langhz666/stm32-sizhoufeixingqi/asset/remote.jpg

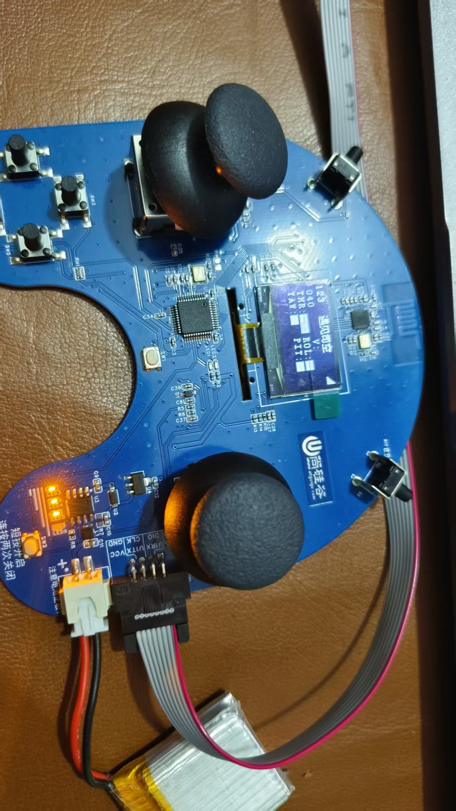
asset/remote.jpg
