langhz666/stm32-sizhoufeixingqi/Software/Flight_code/README.md

# STM32F103 四旋翼飞控系统

## 项目简介

基于STM32F103C8T6的四旋翼飞行器飞控系统，采用FreeRTOS实时操作系统，支持遥控飞行、定高悬停、自动降落等功能。

### 主要特性

- 串级PID控制 (角度环 + 角速度环)
- Mahony互补滤波姿态解算
- VL53L1X激光定高
- SI24R1 2.4G无线通信
- 自动解锁/锁定保护
- 遥控器断连自动降落
- LED状态指示
- 电池电压回传

---

## 硬件平台

### 核心器件

| 模块 | 型号 | 接口 | 引脚 | 说明 |
|---|---|---|---|---|
| 主控 | STM32F103C8T6 | - | - | ARM Cortex-M3, 72MHz, 64KB Flash, 20KB SRAM |
| IMU | MPU6050 | I2C1 | PB6(SCL), PB7(SDA) | 六轴姿态传感器, ±2000°/s, ±2g |
| 无线 | SI24R1 | SPI1 | PA5(CLK), PA6(MISO), PA7(MOSI), PA4(NSS) | 2.4G遥控通信, 1Mbps |
| 测距 | VL53L1X | I2C2 | PB10(SCL), PB11(SDA) | 激光测距, 40-4000mm |
| 电源 | IP5305T | GPIO | PB2(POWER_KEY) | 锂电池电源管理, 自动开关机 |
| 电池ADC | - | ADC1 | PB5(BAT_ADC) | 电池电压检测, 分压电阻1:2 |

### 电机配置

| 电机位置 | 定时器 | 通道 | 引脚 | 旋转方向 |
|---|---|---|---|---|
| 左上 | TIM3 | CH1 | PA6 | 顺时针 |
| 左下 | TIM4 | CH4 | PB9 | 逆时针 |
| 右上 | TIM2 | CH2 | PA1 | 顺时针 |
| 右下 | TIM1 | CH3 | PA10 | 逆时针 |

### LED配置

| LED | 引脚 | 功能 |
|-----|---|---|
| LED1 (左上) | PA12 | 遥控器连接状态 |
| LED2 (右上) | PA11 | 遥控器连接状态 |
| LED3 (右下) | PB15 | 飞行状态指示 |
| LED4 (左下) | PB14 | 飞行状态指示 |

### 电机布局 (俯视图)

```
        左上(顺时针)          右上(顺时针)
              \                /
               \              /
                \            /
                 ------------
                /            \
               /              \
              /                \
        左下(逆时针)          右下(逆时针)
```

---

## 软件架构

### 目录结构

```
├── Core/                        # STM32 HAL库生成代码
│   ├── Inc/                     # 头文件 (CubeMX生成)
│   │   ├── main.h              # 主头文件, GPIO引脚定义
│   │   ├── stm32f1xx_it.h      # 中断处理头文件
│   │   └── ...                 # 其他外设头文件
│   └── Src/                     # 源文件
│       ├── main.c              # 主程序入口
│       ├── stm32f1xx_it.c      # 中断处理 (含FreeRTOS SysTick)
│       └── ...                 # 其他外设初始化
│
├── Drivers/                     # STM32 HAL驱动库 (官方)
│   ├── CMSIS/                   # ARM CMSIS核心
│   └── STM32F1xx_HAL_Driver/   # STM32 HAL库
│
└── MDK-ARM/                     # 用户代码
    ├── Application/             # 应用层 (业务逻辑)
    │   ├── App_flight.c/h      # 飞行控制 (姿态解算+PID+混控)
    │   ├── App_freeRTOS_Task.c/h # FreeRTOS任务管理
    │   └── App_receive_data.c/h # 遥控数据接收与状态机
    │
    ├── common/                  # 公共模块 (算法)
    │   ├── Com_config.c/h      # 系统配置与数据结构
    │   ├── Com_debug.c/h       # 调试打印
    │   ├── Com_filter.c/h      # 滤波算法 (低通+卡尔曼)
    │   ├── Com_imu.c/h         # IMU姿态解算 (Mahony互补滤波)
    │   └── Com_pid.c/h         # PID控制算法
    │
    ├── interface/               # 硬件驱动层
    │   ├── Int_Mpu6050.c/h     # MPU6050驱动 (I2C)
    │   ├── Int_SI24R1.c/h      # SI24R1无线驱动 (SPI)
    │   ├── Int_motor.c/h       # 电机PWM驱动
    │   ├── Int_led.c/h         # LED驱动
    │   ├── Int_IP5305T.c/h     # 电源管理驱动
    │   ├── Int_bat_ADC.c/h     # 电池电压检测
    │   └── fix_height/         # 定高传感器
    │       ├── Int_VL53L1X.c/h # VL53L1X驱动
    │       ├── VL53L1X_api.c/h # ST官方API
    │       └── ...             # 平台适配层
    │
    └── freeRTOS/                # FreeRTOS内核 (官方)
        ├── tasks.c             # 任务管理
        ├── queue.c             # 队列
        ├── timers.c            # 软件定时器
        └── portable/           # 移植层
```

### 软件分层

```
┌─────────────────────────────────────────────────────────────┐
│                    应用层 (Application)                       │
│   App_flight.c        - 飞行控制业务逻辑                     │
│   App_receive_data.c  - 遥控数据解析与状态机                 │
│   App_freeRTOS_Task.c - 任务创建与调度                       │
├─────────────────────────────────────────────────────────────┤
│                    公共模块 (Common)                          │
│   Com_pid.c      - PID控制算法                              │
│   Com_imu.c      - 姿态解算算法                             │
│   Com_filter.c   - 滤波算法                                 │
│   Com_config.c   - 数据结构定义                             │
├─────────────────────────────────────────────────────────────┤
│                    硬件驱动层 (Interface)                     │
│   Int_Mpu6050.c  - MPU6050驱动                              │
│   Int_SI24R1.c   - SI24R1无线驱动                           │
│   Int_motor.c    - 电机驱动                                 │
│   Int_led.c      - LED驱动                                  │
│   Int_VL53L1X.c  - 激光测距驱动                             │
├─────────────────────────────────────────────────────────────┤
│                    HAL库层 (Drivers)                          │
│   STM32F1xx_HAL_Driver - STM32硬件抽象层                    │
│   CMSIS                 - ARM核心支持                       │
├─────────────────────────────────────────────────────────────┤
│                    硬件层 (Hardware)                          │
│   STM32F103C8T6 + MPU6050 + SI24R1 + VL53L1X + 电机        │
└─────────────────────────────────────────────────────────────┘
```

---

## 系统任务

### FreeRTOS任务配置

| 任务名 | 周期 | 优先级 | 栈大小 | 功能 |
|---|---|---|---|---|
| flight_task | 6ms (166Hz) | 3 | 512B | 姿态解算、PID控制、电机输出 |
| com_task | 10ms (100Hz) | 4 | 512B | 遥控数据接收、状态机处理 |
| power_task | 10s | 4 | 512B | 电源管理、自动开关机 |
| led_task | 100ms (10Hz) | 1 | 512B | 状态指示灯控制 |

### 任务优先级说明

- 优先级数值越小，优先级越低
- flight_task 优先级最高 (3)，确保姿态控制实时性
- com_task 和 power_task 优先级相同 (4)
- led_task 优先级最低 (1)，不影响飞行控制

### 任务间通信

```
com_task ──(TaskNotify)──> power_task    // 关机指令
flight_task ──(TaskNotify)──> com_task   // 故障处理完成
```

---

## 控制算法

### 1. 姿态解算 (Mahony互补滤波)

#### 算法原理

融合陀螺仪和加速度计数据，使用四元数表示姿态：

```
陀螺仪: 短期精度高，长期有漂移
加速度计: 长期稳定，短期有噪声

融合公式:
Gyro_corrected = Gyro_raw + Kp * error + Ki * ∫error dt

其中:
error = Acc_norm × Gravity_estimated (叉积表示姿态误差)
```

#### 参数配置

| 参数 | 值 | 说明 |
|---|-----|---|
| Kp | 0.8 | 加速度计修正权重 |
| Ki | 0.0003 | 陀螺仪零偏补偿 |
| 陀螺仪量程 | ±2000°/s | MPU6050配置 |
| 加速度计量程 | ±2g | MPU6050配置 |
| 积分时间 | 6ms | 任务周期 |

#### 输出

- 俯仰角 (Pitch): 绕Y轴旋转，抬头为正，范围 [-90°, +90°]
- 横滚角 (Roll): 绕X轴旋转，右倾为正，范围 [-180°, +180°]
- 偏航角 (Yaw): 绕Z轴旋转，顺时针为正，累积值

### 2. PID控制 (串级PID)

#### 控制结构

```
                    ┌─────────────┐
目标角度 ──────────>│   外环PID   │──────> 目标角速度
                    │  (角度环)   │
                    └─────────────┘
                           │
                           ▼
                    ┌─────────────┐
当前角速度 ────────>│   内环PID   │──────> 电机控制量
                    │ (角速度环)  │
                    └─────────────┘
```

#### 优势

- 内环响应快，能快速抑制角速度扰动
- 外环负责稳态精度
- 比单级PID具有更好的抗干扰性能

#### PID公式

```
output = Kp * err + Ki * ∫err*dt + Kd * derr/dt

其中:
err = measure - desire
```

#### 参数配置

**俯仰轴 (Pitch):**
| 环路 | Kp | Ki | Kd | 说明 |
|---|-----|-----|-----|---|
| 外环 (角度) | -3.50 | 0 | 0 | 纯比例控制 |
| 内环 (角速度) | 5.50 | 0 | 0.15 | 比例+微分 |

**横滚轴 (Roll):**
| 环路 | Kp | Ki | Kd | 说明 |
|---|-----|-----|-----|---|
| 外环 (角度) | -3.50 | 0 | 0 | 纯比例控制 |
| 内环 (角速度) | 5.50 | 0 | 0.15 | 比例+微分 |

**偏航轴 (Yaw):**
| 环路 | Kp | Ki | Kd | 说明 |
|---|-----|-----|-----|---|
| 外环 (角度) | -1.50 | 0 | 0 | 纯比例控制 |
| 内环 (角速度) | -2.50 | 0 | 0 | 纯比例控制 |

**高度环 (Height):**
| 环路 | Kp | Ki | Kd | 说明 |
|---|-----|-----|-----|---|
| 高度 | -1.3 | 0 | -0.05 | 比例+微分 |

#### 调参建议

1. **先调内环**: 确保角速度能快速跟踪指令
   - 从小Kp开始，逐渐增大
   - 加入适当的Kd抑制振荡

2. **再调外环**: 确保角度能快速稳定
   - 从小Kp开始，逐渐增大
   - 外环一般不需要Kd

3. **微调**: 根据飞行效果微调参数
   - 如果振荡: 减小Kp或增大Kd
   - 如果响应慢: 增大Kp
   - 如果有静态误差: 适当增加Ki

### 3. 滤波算法

#### 低通滤波 (陀螺仪)

```
output = alpha * newValue + (1-alpha) * preFilteredValue

参数: alpha = 0.15
作用: 滤除高频噪声
特点: 响应快，适合高频数据
```

#### 卡尔曼滤波 (加速度计)

```
预测:
P(k|k-1) = P(k-1|k-1) + Q

更新:
K = P(k|k-1) / (P(k|k-1) + R)
x(k|k) = x(k|k-1) + K * (z(k) - x(k|k-1))
P(k|k) = (1-K) * P(k|k-1)

参数: Q=0.001, R=0.543
作用: 平滑数据，滤除噪声
特点: 平滑性好，适合低频数据
```

### 4. 电机混控 (X型布局)

#### 混控公式

```
左上电机 = 油门 + 俯仰 - 横滚 + 偏航
左下电机 = 油门 - 俯仰 - 横滚 - 偏航
右上电机 = 油门 + 俯仰 + 横滚 - 偏航
右下电机 = 油门 - 俯仰 + 横滚 + 偏航
```

#### 符号说明

- 俯仰+: 抬头 (左上、右上电机加速)
- 横滚+: 右倾 (右上、右下电机加速)
- 偏航+: 顺时针旋转 (左上、左下电机加速)

#### 限幅

- 电机速度范围: 0-700 (PWM比较值)
- 偏航输出限幅: ±100 (防止过度旋转)
- 油门<50时强制停止 (安全保护)

---

## 飞行状态机

### 状态转换图

```
                    ┌──────────────────────────────────────┐
                    │                                      │
                    ▼                                      │
                ┌───────┐    解锁成功     ┌─────────┐     │
                │ IDLE  │───────────────>│ NORMAL  │     │
                │ (空闲) │                │ (正常)  │     │
                └───────┘                └─────────┘     │
                    ▲                        │           │
                    │                        │ 定高指令   │
                    │                        ▼           │
                    │                   ┌──────────┐     │
                    │                   │FIX_HEIGHT│     │
                    │                   │ (定高)   │     │
                    │                   └──────────┘     │
                    │                        │           │
                    │                        │ 遥控断连   │
                    │                        ▼           │
                    │                   ┌──────────┐     │
                    │                   │   FAIL   │     │
                    │                   │ (故障)   │     │
                    │                   └──────────┘     │
                    │                        │           │
                    │                        │ 电机停止   │
                    └────────────────────────┘           │
                                                         │
                    ┌────────────────────────────────────┘
                    │
                    │ 取消定高
                    ▼
                ┌─────────┐
                │ NORMAL  │
                └─────────┘
```

### 状态说明

| 状态 | 说明 | LED指示 |
|---|---|---|
| IDLE | 空闲状态，电机停止，等待解锁 | 慢闪 (500ms) |
| NORMAL | 正常飞行，三轴PID控制 | 快闪 (200ms) |
| FIX_HEIGHT | 定高飞行，三轴PID + 高度PID | 常亮 |
| FAIL | 故障状态，遥控器断连，缓慢减速降落 | 常灭 |

### 解锁流程 (安全保护)

```
Step 1: 油门推到最高 (>900)
         │
         ▼
Step 2: 保持1秒以上
         │
         ▼
Step 3: 油门拉到最低 (<100)
         │
         ▼
Step 4: 保持1秒以上
         │
         ▼
Step 5: 解锁成功，进入NORMAL状态
```

### 状态转换条件

| 转换 | 条件 | 说明 |
|---|---|---|
| IDLE → NORMAL | 解锁成功 | 油门推到最高->保持->拉到最低->保持 |
| NORMAL → FIX_HEIGHT | 定高指令 | 遥控器fix_height=1 |
| NORMAL → FAIL | 遥控断连 | 连续10次接收失败 |
| FIX_HEIGHT → NORMAL | 取消定高 | 遥控器fix_height=1 |
| FIX_HEIGHT → FAIL | 遥控断连 | 连续10次接收失败 |
| FAIL → IDLE | 电机停止 | 所有电机速度<=0 |

---

## 遥控数据协议

### 数据帧格式 (17字节)

| 字节索引 | 内容 | 长度 | 说明 |
|---|---|---|---|
| 0 | 帧头1 | 1B | 固定值 'l' (0x6C) |
| 1 | 帧头2 | 1B | 固定值 'h' (0x68) |
| 2 | 帧头3 | 1B | 固定值 'z' (0x7A) |
| 3-4 | 油门 | 2B | 0-1000, 大端序, 500为中间值 |
| 5-6 | 偏航 | 2B | 0-1000, 大端序, 500为中间值 |
| 7-8 | 俯仰 | 2B | 0-1000, 大端序, 500为中间值 |
| 9-10 | 横滚 | 2B | 0-1000, 大端序, 500为中间值 |
| 11 | 关机标志 | 1B | 1:关机, 0:正常 |
| 12 | 定高标志 | 1B | 1:切换定高, 0:不切换 |
| 13-16 | 校验和 | 4B | 前13字节之和, 大端序 |

### 校验机制

1. **帧头校验**: 前3字节必须为 'l', 'h', 'z'
2. **校验和校验**: 前13字节之和等于后4字节

### 回复数据帧 (17字节)

飞控收到遥控数据后，会回复电池电压数据：

| 字节索引 | 内容 | 长度 | 说明 |
|---|---|---|---|
| 0-4 | 电池电压 | 5B | ASCII字符串, 如 "4.20" |
| 5-16 | 填充 | 12B | 0x00 |

---

## LED指示说明

### 遥控器连接状态 (前两个LED)

| LED1 (左上) | LED2 (右上) | 说明 |
|---|---|---|
| 亮 | 亮 | 遥控器已连接 |
| 灭 | 灭 | 遥控器断开 |

### 飞行状态 (后两个LED)

| 状态 | LED3 (右下) | LED4 (左下) | 说明 |
|---|---|---|---|
| IDLE | 慢闪 (500ms) | 慢闪 (500ms) | 等待解锁 |
| NORMAL | 快闪 (200ms) | 快闪 (200ms) | 正常飞行 |
| FIX_HEIGHT | 常亮 | 常亮 | 定高飞行 |
| FAIL | 常灭 | 常灭 | 故障降落 |

---

## 开发环境

### 软件工具

| 工具 | 版本 | 用途 |
|---|---|---|
| Keil MDK-ARM | v5 | IDE |
| STM32CubeMX | 6.x | 代码生成 |
| ST-Link | - | 调试下载 |

### 硬件工具

| 工具 | 用途 |
|---|---|
| ST-Link V2 | 调试下载 |
| 逻辑分析仪 | SPI/I2C调试 |
| 示波器 | PWM信号调试 |

### 库版本

| 库 | 版本 | 说明 |
|----|---|---|
| STM32F1xx HAL | 1.x | 硬件抽象层 |
| FreeRTOS | 10.x | 实时操作系统 |
| VL53L1X API | 1.x | 激光测距库 |

---

## 注意事项

### 初始化

1. MPU6050初始化时会自动执行偏移校准，需保持飞机水平静止约2-3秒
2. 校准完成后才能正常飞行
3. SI24R1初始化会进行硬件自检，确保SPI通信正常

### 飞行安全

1. 首次飞行前请检查电机转向是否正确
2. 确保遥控器油门在最低位置再解锁
3. 飞行时保持遥控器与飞机之间无遮挡
4. 电池电压低于3.5V时请及时充电

### 调试

1. 日志打印会占用CPU资源，飞行时建议关闭
   - 修改 `Com_debug.h` 中的 `DEBUG_LOG_ENABLE` 为 0
2. 使用串口调试时，波特率设置为115200
3. 可通过串口观察姿态数据和PID输出

### 常见问题

| 问题 | 可能原因 | 解决方法 |
|---|---|---|
| 电机不转 | 油门未推到最低 | 将油门拉到最低 |
| 飞机乱飞 | MPU6050校准失败 | 重新上电，保持水平静止 |
| 遥控器断连 | 信号被遮挡 | 调整天线方向，减少遮挡 |
| 定高不稳 | 激光传感器脏污 | 清洁传感器窗口 |

---

## 作者

- 作者: langhz666
- 邮箱: 3204498297@qq.com

## 许可证

本项目仅供学习交流使用。
