langhz666/stm32-sizhoufeixingqi/Hardware/无人机遥控器.pdf

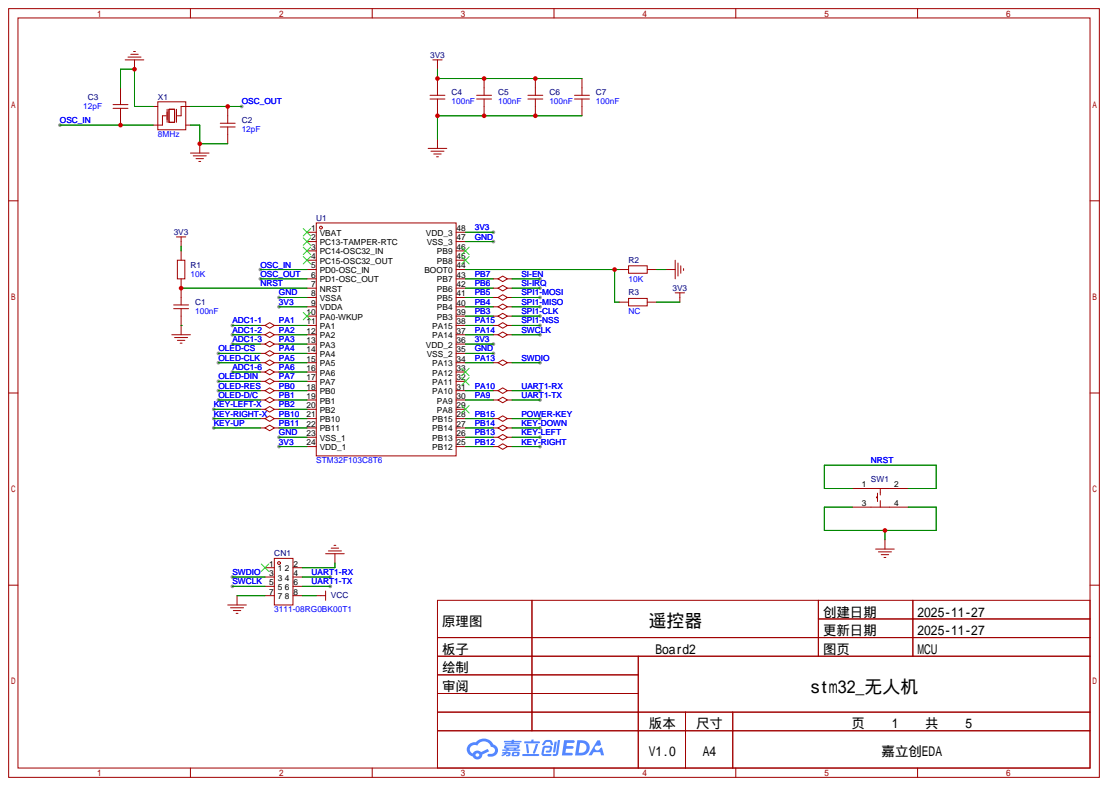
[picture p2: page 1]

原理图 | 遥控器 | 创建日期 | 2025-11-27

更新日期 | 2025-11-27

板子 | Board2 | 图页 | MCU
绘制 | | stm32_无人机
审阅

V1.0 | A4 | 嘉立创EDA

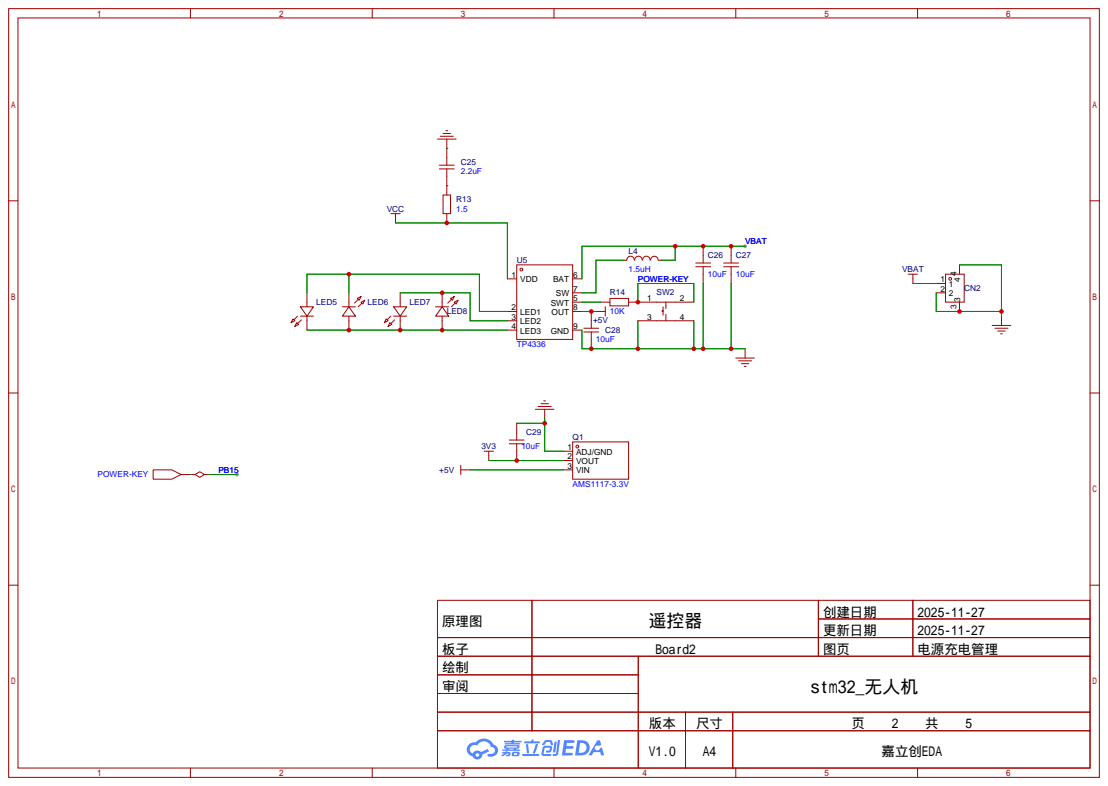
[picture p3: page 2]

原理图 | 遥控器 | 创建日期 | 2025-11-27

更新日期 | 2025-11-27

板子 | Board2 | 图页 | 电源充电管理
绘制 | | stm32_无人机
审阅

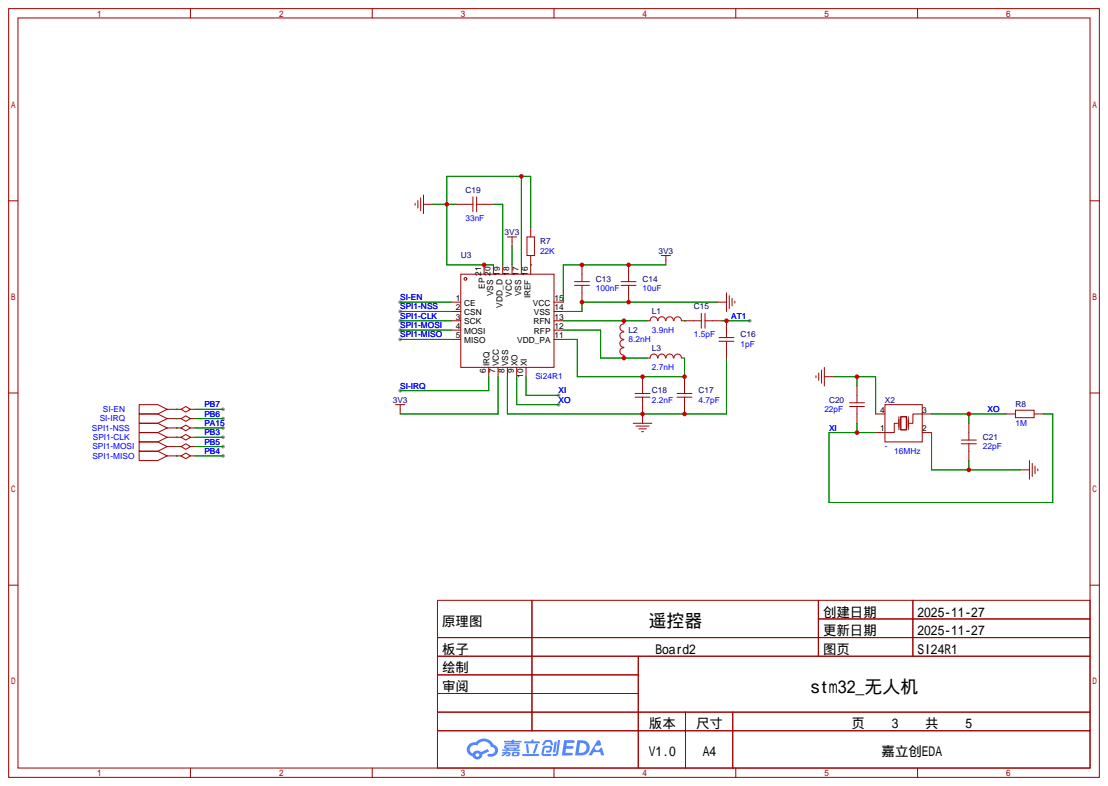
[picture p4: page 3]

VDD_PA 11 RFP 12 RFN 13 VSS 14 VCC 15 IREF 16 VSS ¹⁷

原理图 | 遥控器 | 创建日期 | 2025-11-27

更新日期 | 2025-11-27

板子 | Board2 | 图页 | SI24R1
绘制 | | stm32_无人机
审阅

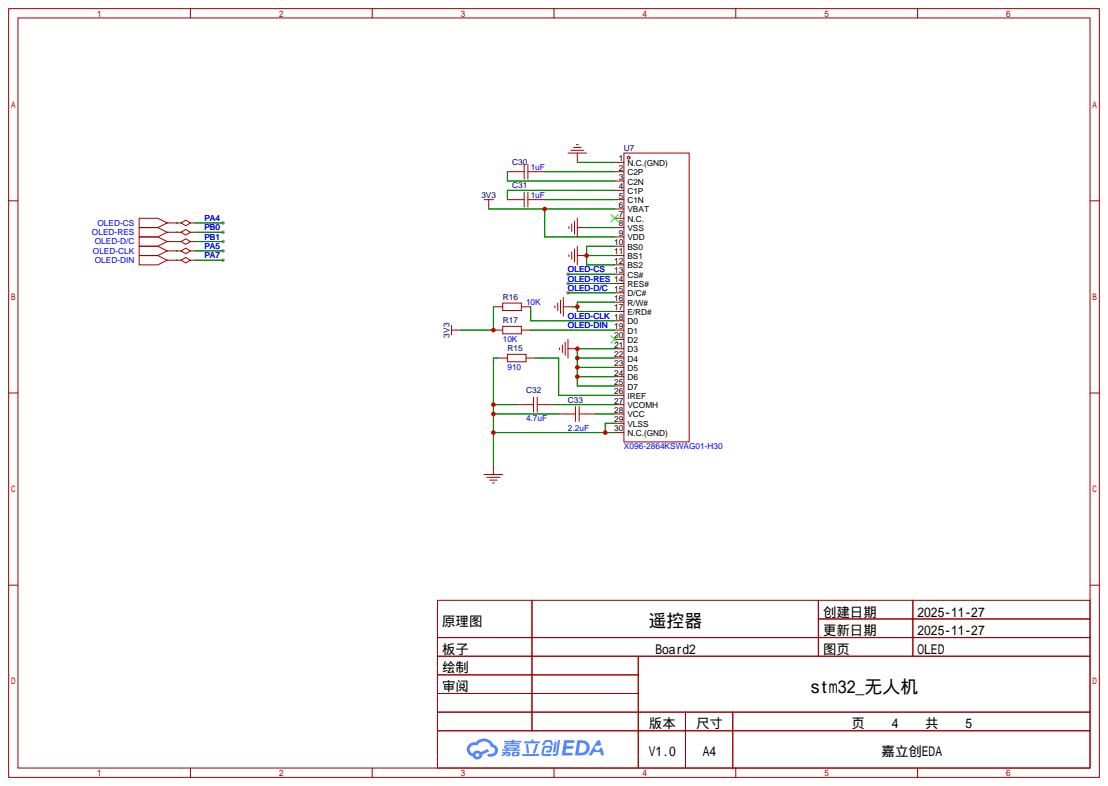
[picture p5: page 4]

原理图 | 遥控器 | 创建日期 | 2025-11-27

更新日期 | 2025-11-27

板子 | Board2 | 图页 | OLED
绘制 | | stm32_无人机
审阅

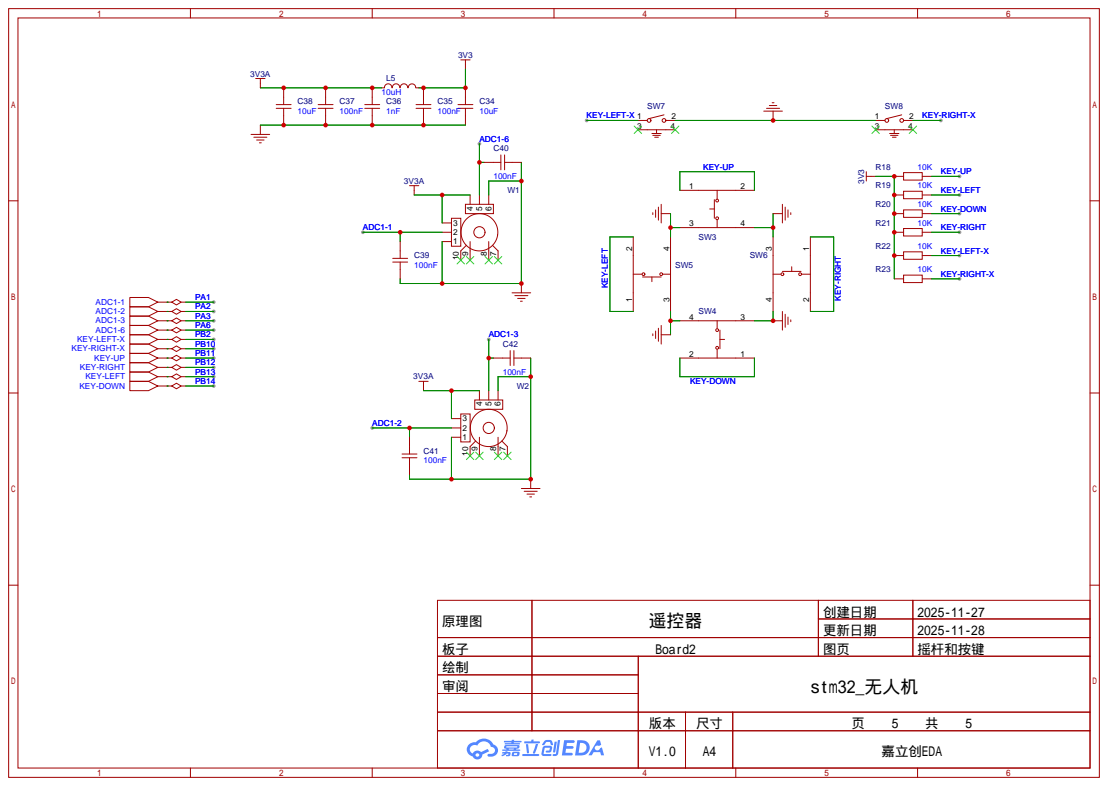
[picture p6: page 5]

原理图 | 遥控器 | 创建日期 | 2025-11-27

更新日期 | 2025-11-28

板子 | Board2 | 图页 | 摇杆和按键
绘制 | | stm32_无人机
审阅
