langhz666/stm32-sizhoufeixingqi/Hardware/无人机飞控板.pdf

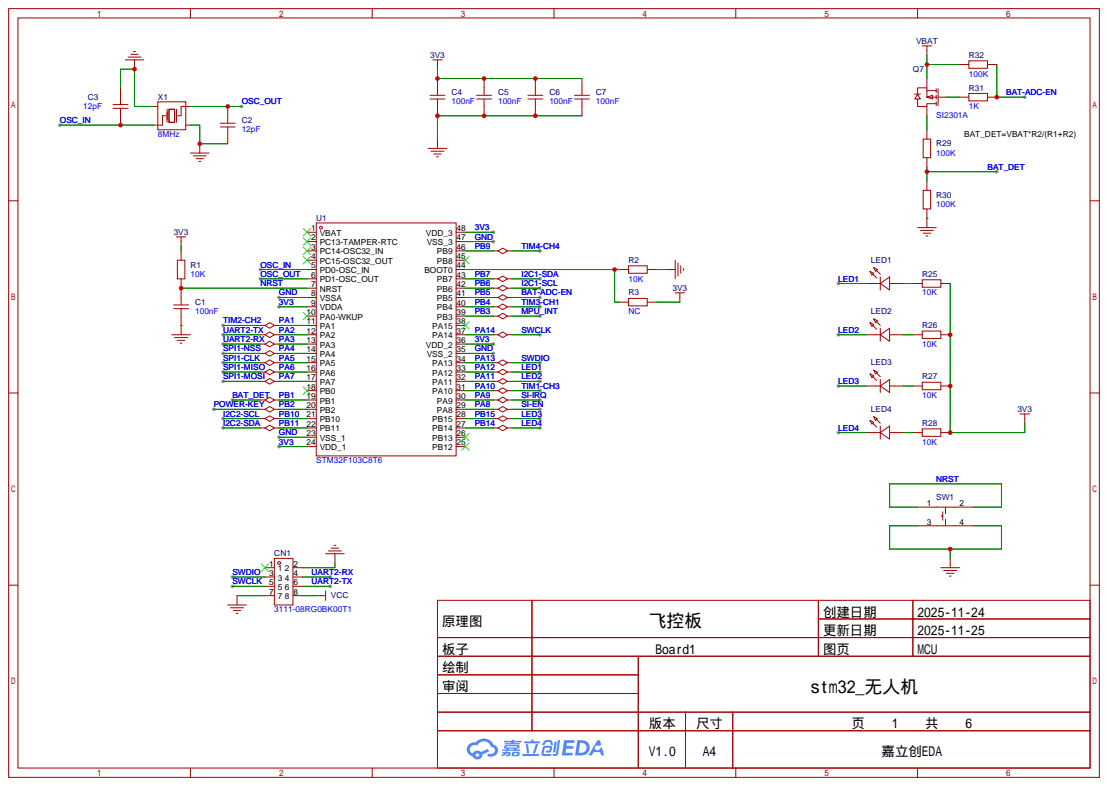
[picture p7: page 1]

原理图 | 飞控板 | 创建日期 | 2025-11-24

更新日期 | 2025-11-25

板子 | Board1 | 图页 | MCU
绘制 | | stm32_无人机
审阅

V1.0 | A4 | 嘉立创EDA

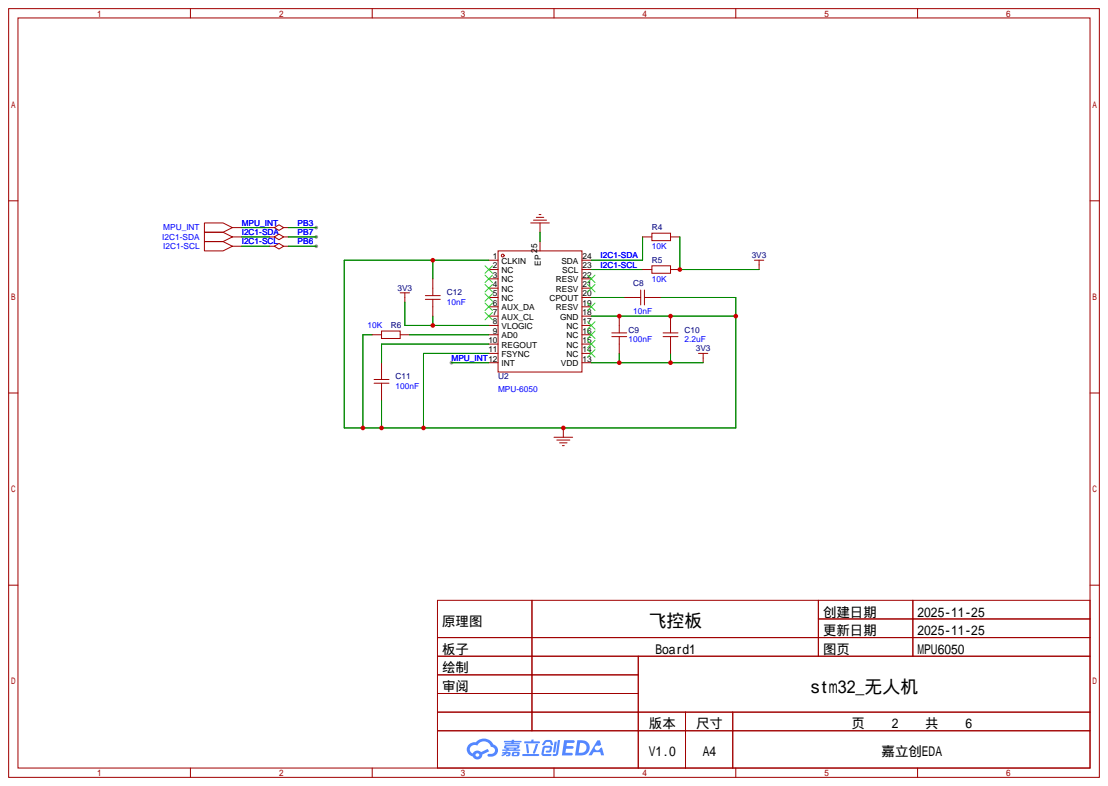
[picture p8: page 2]

原理图 | 飞控板 | 创建日期 | 2025-11-25

更新日期 | 2025-11-25

板子 | Board1 | 图页 | MPU6050
绘制 | | stm32_无人机
审阅

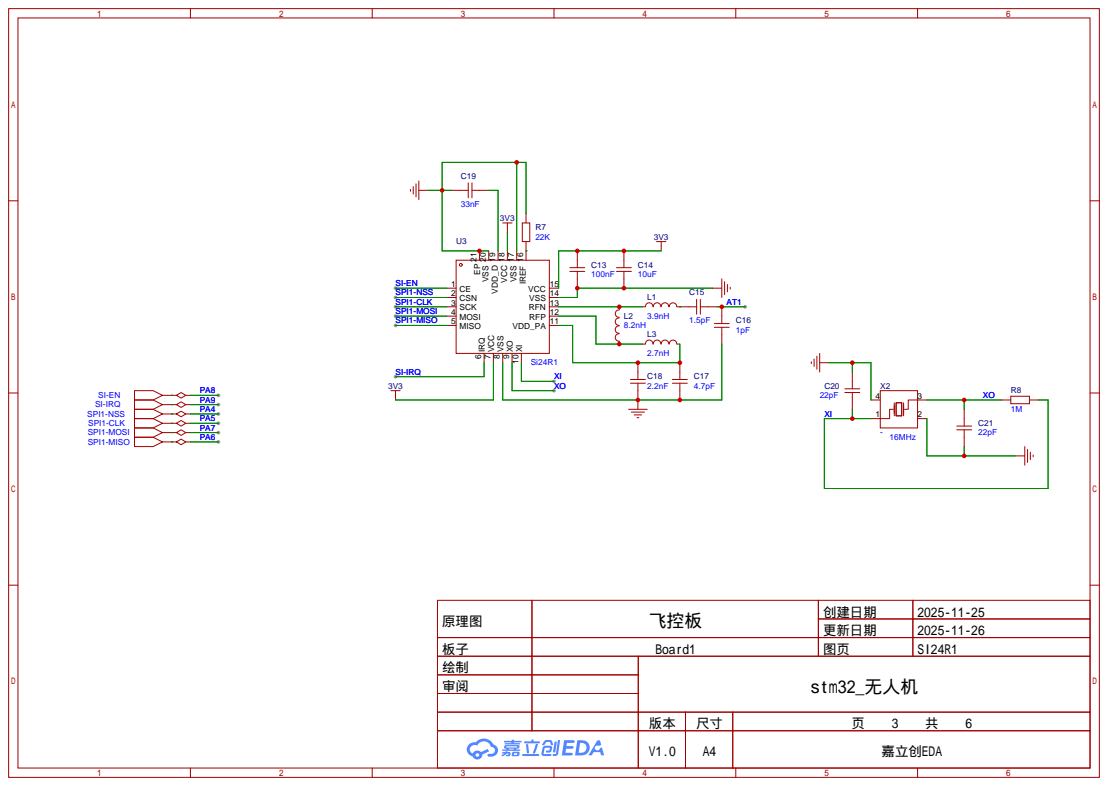
[picture p9: page 3]

VDD_PA 11 RFP 12 RFN 13 VSS 14 VCC 15 IREF 16 VSS ¹⁷

原理图 | 飞控板 | 创建日期 | 2025-11-25

更新日期 | 2025-11-26

板子 | Board1 | 图页 | SI24R1
绘制 | | stm32_无人机
审阅

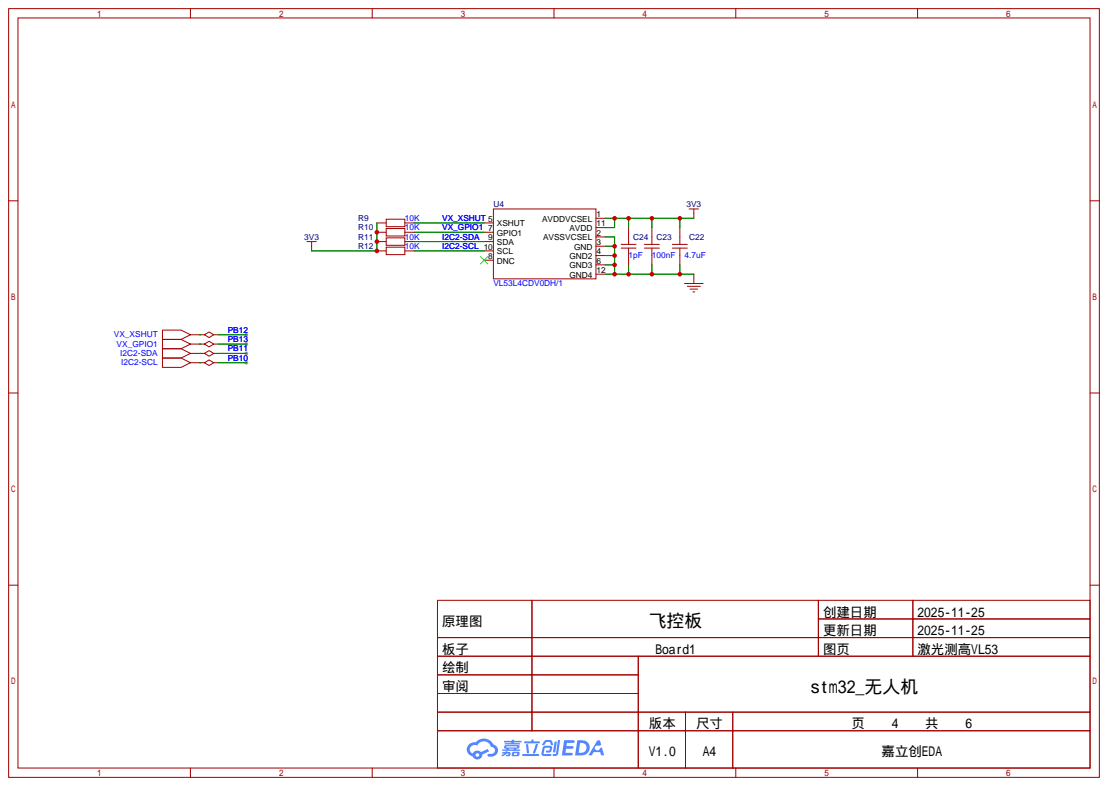
[picture p10: page 4]

原理图 | 飞控板 | 创建日期 | 2025-11-25

更新日期 | 2025-11-25

板子 | Board1 | 图页 | 激光测高VL53
绘制 | | stm32_无人机
审阅

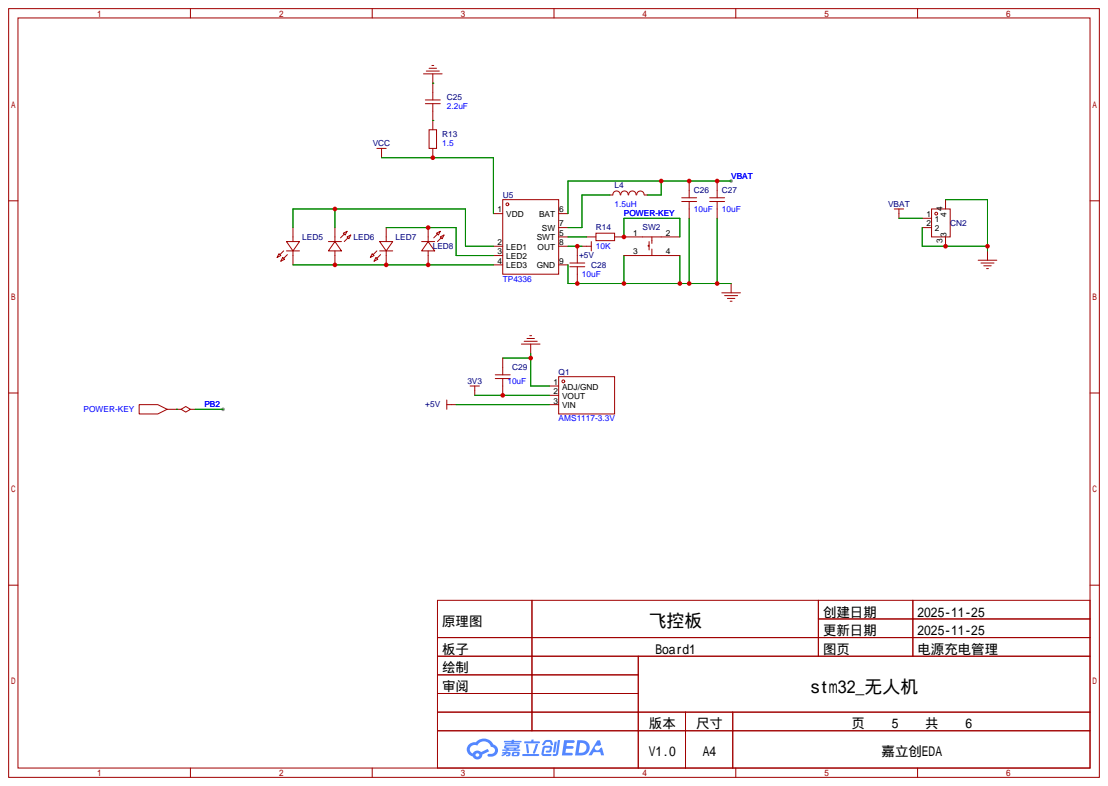
[picture p11: page 5]

原理图 | 飞控板 | 创建日期 | 2025-11-25

更新日期 | 2025-11-25

板子 | Board1 | 图页 | 电源充电管理
绘制 | | stm32_无人机
审阅

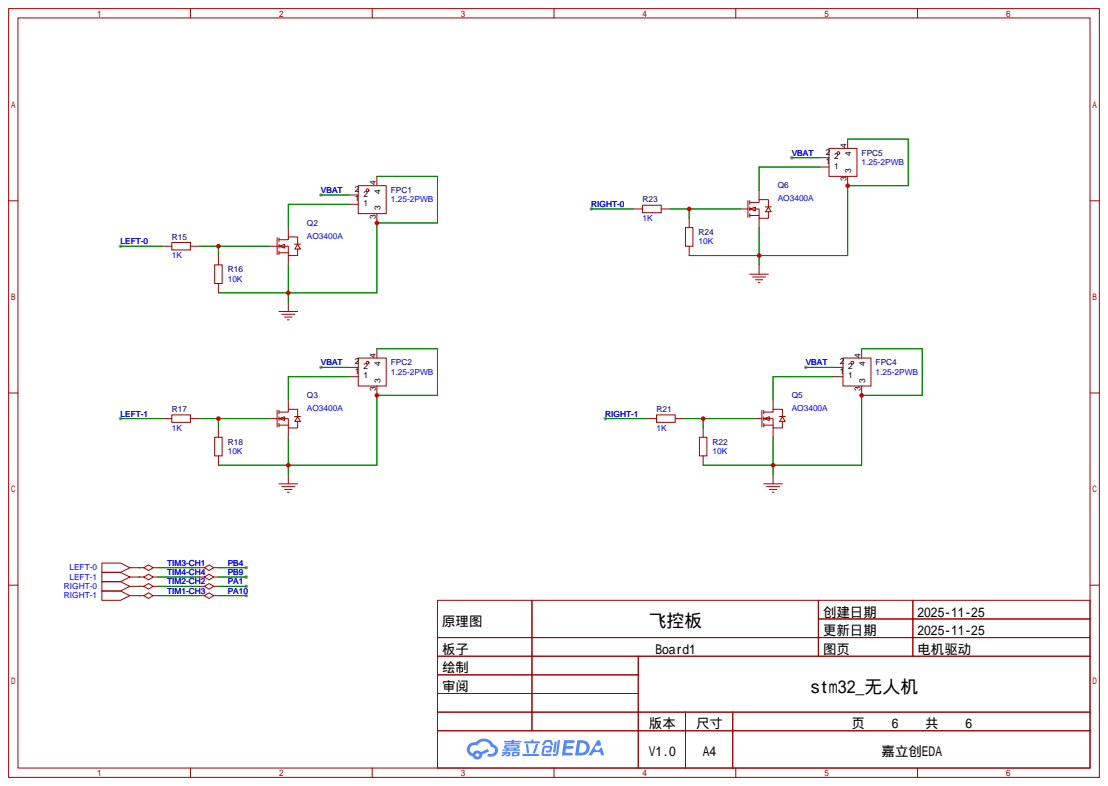
[picture p12: page 6]

原理图 | 飞控板 | 创建日期 | 2025-11-25

更新日期 | 2025-11-25

板子 | Board1 | 图页 | 电机驱动
绘制 | | stm32_无人机
审阅
