langhz666/stm32-sizhoufeixingqi/(list of files, drawings)

Other design files:
Hardware/stm32_无人机.eprj
