langhz666/stm32-sizhoufeixingqi/Software/Remote_code/Core/Inc/main.h

#define KEY_UP_Pin              GPIO_PIN_11     /**< 上方向键 */
#define KEY_UP_GPIO_Port        GPIOB
#define KEY_DOWN_Pin            GPIO_PIN_14     /**< 下方向键 */
#define KEY_DOWN_GPIO_Port      GPIOB
#define KEY_LEFT_Pin            GPIO_PIN_13     /**< 左方向键 */
#define KEY_LEFT_GPIO_Port      GPIOB
#define KEY_RIGHT_Pin           GPIO_PIN_12     /**< 右方向键 */
#define KEY_RIGHT_GPIO_Port     GPIOB
#define KEY_LEFT_X_Pin          GPIO_PIN_2      /**< 左侧功能键 */
#define KEY_LEFT_X_GPIO_Port    GPIOB
#define KEY_RIGHT_X_Pin         GPIO_PIN_10     /**< 右侧功能键（支持长按） */
#define KEY_RIGHT_X_GPIO_Port   GPIOB
#define POWER_KEY_Pin           GPIO_PIN_15     /**< IP5305T电源按键（低电平有效） */
#define POWER_KEY_GPIO_Port     GPIOB
#define SPI1_NSS_Pin            GPIO_PIN_15     /**< SPI片选（低电平有效，软件控制） */
#define SPI1_NSS_GPIO_Port      GPIOA
#define SI_EN_Pin               GPIO_PIN_7      /**< SI24R1芯片使能（高电平使能） */
#define SI_EN_GPIO_Port         GPIOB
