langhz666/stm32-sizhoufeixingqi/Software/Remote_code/MDK-ARM/interface/oled/Inf_font.c

/**
 * @file    Inf_font.c
 * @brief   OLED字库数据文件
 * @author  langhz666
 * @date    2025-09-27
 *
 * @details 本文件包含OLED显示模块使用的字库点阵数据：
 *          - oled_asc2_1206：6x12像素ASCII字库
 *          - oled_asc2_1608：8x16像素ASCII字库
 *          - oled_CH_1616：16x16像素中文字符字库
 *
 * 字库说明：
 * - ASCII字库：95个字符（从空格' '~'~'），偏移量=字符-32
 * - 中文字库：半角存储，每个中文字符占12字节
 * - 字库数据由取模软件生成，阴码取模，列行式，逆向
 *
 * @note   字库数据存储在Flash中（const修饰）
 * @note   修改字库需使用取模软件重新生成
 */

#include "Inf_font.h"

/* ======================== 6x12像素ASCII字库 ======================== */

/**
 * @brief 6x12像素ASCII字库
 *
 * @details 95个可显示ASCII字符（0x20~0x7E）
 *          - 每字符12字节
 *          - 字符宽度6像素，高度12像素
 *          - 取模方式：阴码，列行式，逆向
 *
 * @note   偏移量=ASCII码-32（空格为0）
 * @note   共95个字符，覆盖空格到'~'
 */
const unsigned char oled_asc2_1206[95][12] = {
    {0x00, 0x00, 0x00, 0x00, 0x00, 0x00, 0x00, 0x00, 0x00, 0x00, 0x00, 0x00}, /*" ",0*/
    {0x00, 0x00, 0x00, 0x00, 0x3F, 0x40, 0x00, 0x00, 0x00, 0x00, 0x00, 0x00}, /*"!",1*/
    {0x00, 0x00, 0x30, 0x00, 0x40, 0x00, 0x30, 0x00, 0x40, 0x00, 0x00, 0x00}, /*""",2*/
    {0x09, 0x00, 0x0B, 0xC0, 0x3D, 0x00, 0x0B, 0xC0, 0x3D, 0x00, 0x09, 0x00}, /*"#",3*/
    {0x18, 0xC0, 0x24, 0x40, 0x7F, 0xE0, 0x22, 0x40, 0x31, 0x80, 0x00, 0x00}, /*"$",4*/
    {0x18, 0x00, 0x24, 0xC0, 0x1B, 0x00, 0x0D, 0x80, 0x32, 0x40, 0x01, 0x80}, /*"%",5*/
    {0x03, 0x80, 0x1C, 0x40, 0x27, 0x40, 0x1C, 0x80, 0x07, 0x40, 0x00, 0x40}, /*"&",6*/
    {0x10, 0x00, 0x60, 0x00, 0x00, 0x00, 0x00, 0x00, 0x00, 0x00, 0x00, 0x00}, /*"'",7*/
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
    {0x7F, 0xE0, 0x7F, 0xE0, 0x00, 0x00, 0x00, 0x00, 0x00, 0x00, 0x00, 0x00}, // 14

    {0x7F, 0xE0, 0x7F, 0xE0, 0x7F, 0xE0, 0x7F, 0xE0, 0x7F, 0xE0, 0x7F, 0xE0},
    {0x7F, 0xE0, 0x7F, 0xE0, 0x7F, 0xE0, 0x00, 0x00, 0x00, 0x00, 0x00, 0x00}, // 15

    {0x7F, 0xE0, 0x7F, 0xE0, 0x7F, 0xE0, 0x7F, 0xE0, 0x7F, 0xE0, 0x7F, 0xE0},
    {0x7F, 0xE0, 0x7F, 0xE0, 0x7F, 0xE0, 0x7F, 0xE0, 0x00, 0x00, 0x00, 0x00}, // 16

    {0x7F, 0xE0, 0x7F, 0xE0, 0x7F, 0xE0, 0x7F, 0xE0, 0x7F, 0xE0, 0x7F, 0xE0},
    {0x7F, 0xE0, 0x7F, 0xE0, 0x7F, 0xE0, 0x7F, 0xE0, 0x7F, 0xE0, 0x00, 0x00}, // 17

    {0x7F, 0xE0, 0x7F, 0xE0, 0x7F, 0xE0, 0x7F, 0xE0, 0x7F, 0xE0, 0x7F, 0xE0},
    {0x7F, 0xE0, 0x7F, 0xE0, 0x7F, 0xE0, 0x7F, 0xE0, 0x7F, 0xE0, 0x7F, 0xE0}, // 18
    /* ======================== WiFi图标 ======================== */
    {0x00, 0x00, 0x00, 0x00, 0x4C, 0x00, 0x2A, 0x00, 0x09, 0xE0, 0x28, 0x20},
    {0x28, 0x20, 0x09, 0xE0, 0x2A, 0x00, 0x4C, 0x00, 0x00, 0x00, 0x00, 0x00}, /*WiFi,19*/

    /* 电池图标 */
    {0x00, 0x00, 0x40, 0x20, 0x26, 0x40, 0x15, 0x80, 0x0D, 0xE0, 0x16, 0x20},
    {0x16, 0x20, 0x0D, 0xE0, 0x15, 0x80, 0x26, 0x40, 0x40, 0x20, 0x00, 0x00}, /*电池,20*/

};
