langhz666/stm32-sizhoufeixingqi/Software/Flight_code/MDK-ARM/interface/fix_height/vl53l1_platform.c

/*
 * This file is part of VL53L1 Platform
 *
 * Copyright (c) 2016, STMicroelectronics - All Rights Reserved
 *
 * License terms: BSD 3-clause "New" or "Revised" License.
 *
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
 * 3. Neither the name of the copyright holder nor the names of its contributors
 * may be used to endorse or promote products derived from this software
 * without specific prior written permission.
 *
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
 */

#include "vl53l1_platform.h"
#include <string.h>
#include <time.h>
#include <math.h>

int8_t VL53L1_WriteMulti(uint16_t dev, uint16_t index, uint8_t *pdata, uint32_t count)
{
	return 0; // to be implemented
}

int8_t VL53L1_ReadMulti(uint16_t dev, uint16_t index, uint8_t *pdata, uint32_t count)
{
	return 0; // to be implemented
}

int8_t VL53L1_WrByte(uint16_t dev, uint16_t index, uint8_t data)
{
	// 只写入一个字节
	HAL_I2C_Mem_Write(&hi2c2, dev, index, I2C_MEMADD_SIZE_16BIT, &data, 1, 1000);
	return 0; // to be implemented
}

int8_t VL53L1_WrWord(uint16_t dev, uint16_t index, uint16_t data)
{
	uint8_t data_buf[2] = {0};
	// 使用大端序
	data_buf[0] = data >> 8;
	data_buf[1] = data & 0xFF;

	HAL_I2C_Mem_Write(&hi2c2, dev, index, I2C_MEMADD_SIZE_16BIT, data_buf, 2, 1000);

	return 0; // to be implemented
}

int8_t VL53L1_WrDWord(uint16_t dev, uint16_t index, uint32_t data)
{
	uint8_t data_buf[4] = {0};
	// 使用大端序
	data_buf[0] = data >> 24;
	data_buf[1] = (data >> 16) & 0xFF;
	data_buf[2] = (data >> 8) & 0xFF;
	data_buf[3] = data & 0xFF;
	HAL_I2C_Mem_Write(&hi2c2, dev, index, I2C_MEMADD_SIZE_16BIT, data_buf, 4, 1000);
	return 0; // to be implemented
}

int8_t VL53L1_RdByte(uint16_t dev, uint16_t index, uint8_t *data)
{
	HAL_I2C_Mem_Read(&hi2c2, dev, index, I2C_MEMADD_SIZE_16BIT, data, 1, 1000);
	return 0; // to be implemented
}

int8_t VL53L1_RdWord(uint16_t dev, uint16_t index, uint16_t *data)
{
	// 读取的数据是大端序的
	uint8_t data_buf[2] = {0};

	HAL_I2C_Mem_Read(&hi2c2, dev, index, I2C_MEMADD_SIZE_16BIT, data_buf, 2, 1000);

	*data = (data_buf[0] << 8) | data_buf[1];
	return 0; // to be implemented
}

int8_t VL53L1_RdDWord(uint16_t dev, uint16_t index, uint32_t *data)
{
	uint8_t data_buf[4] = {0};
	HAL_I2C_Mem_Read(&hi2c2, dev, index, I2C_MEMADD_SIZE_16BIT, data_buf, 4, 1000);
	*data = (data_buf[0] << 24) | (data_buf[1] << 16) | (data_buf[2] << 8) | data_buf[3];
	return 0; // to be implemented
}

int8_t VL53L1_WaitMs(uint16_t dev, int32_t wait_ms)
{
	return 0; // to be implemented
}
