langhz666/stm32-sizhoufeixingqi/(commit log)

2026-02-05 Add README for STM32-FreeRTOS Quadcopter project
    Added detailed project description, technical stack, key features, performance metrics, system architecture, and getting started instructions for the STM32-FreeRTOS quadcopter project.
2026-02-05 软件部分
2026-02-05 飞控源码
2026-02-05 硬件部分
2026-05-04 更新readme
